troyn/arduino_pendulum/README.md

Projekt: Automatizirano njihalo, Arduino, FERIT Osijek
Više informacija u .pdf projekta.
